akuker/RASCSI-micromod/hw/micromod_adapter/MicroMod_ATP_CarrierBoard.kicad_pcb

## KiCad design hw/micromod_adapter/MicroMod_ATP_CarrierBoard.kicad_pcb (2022-02-06)

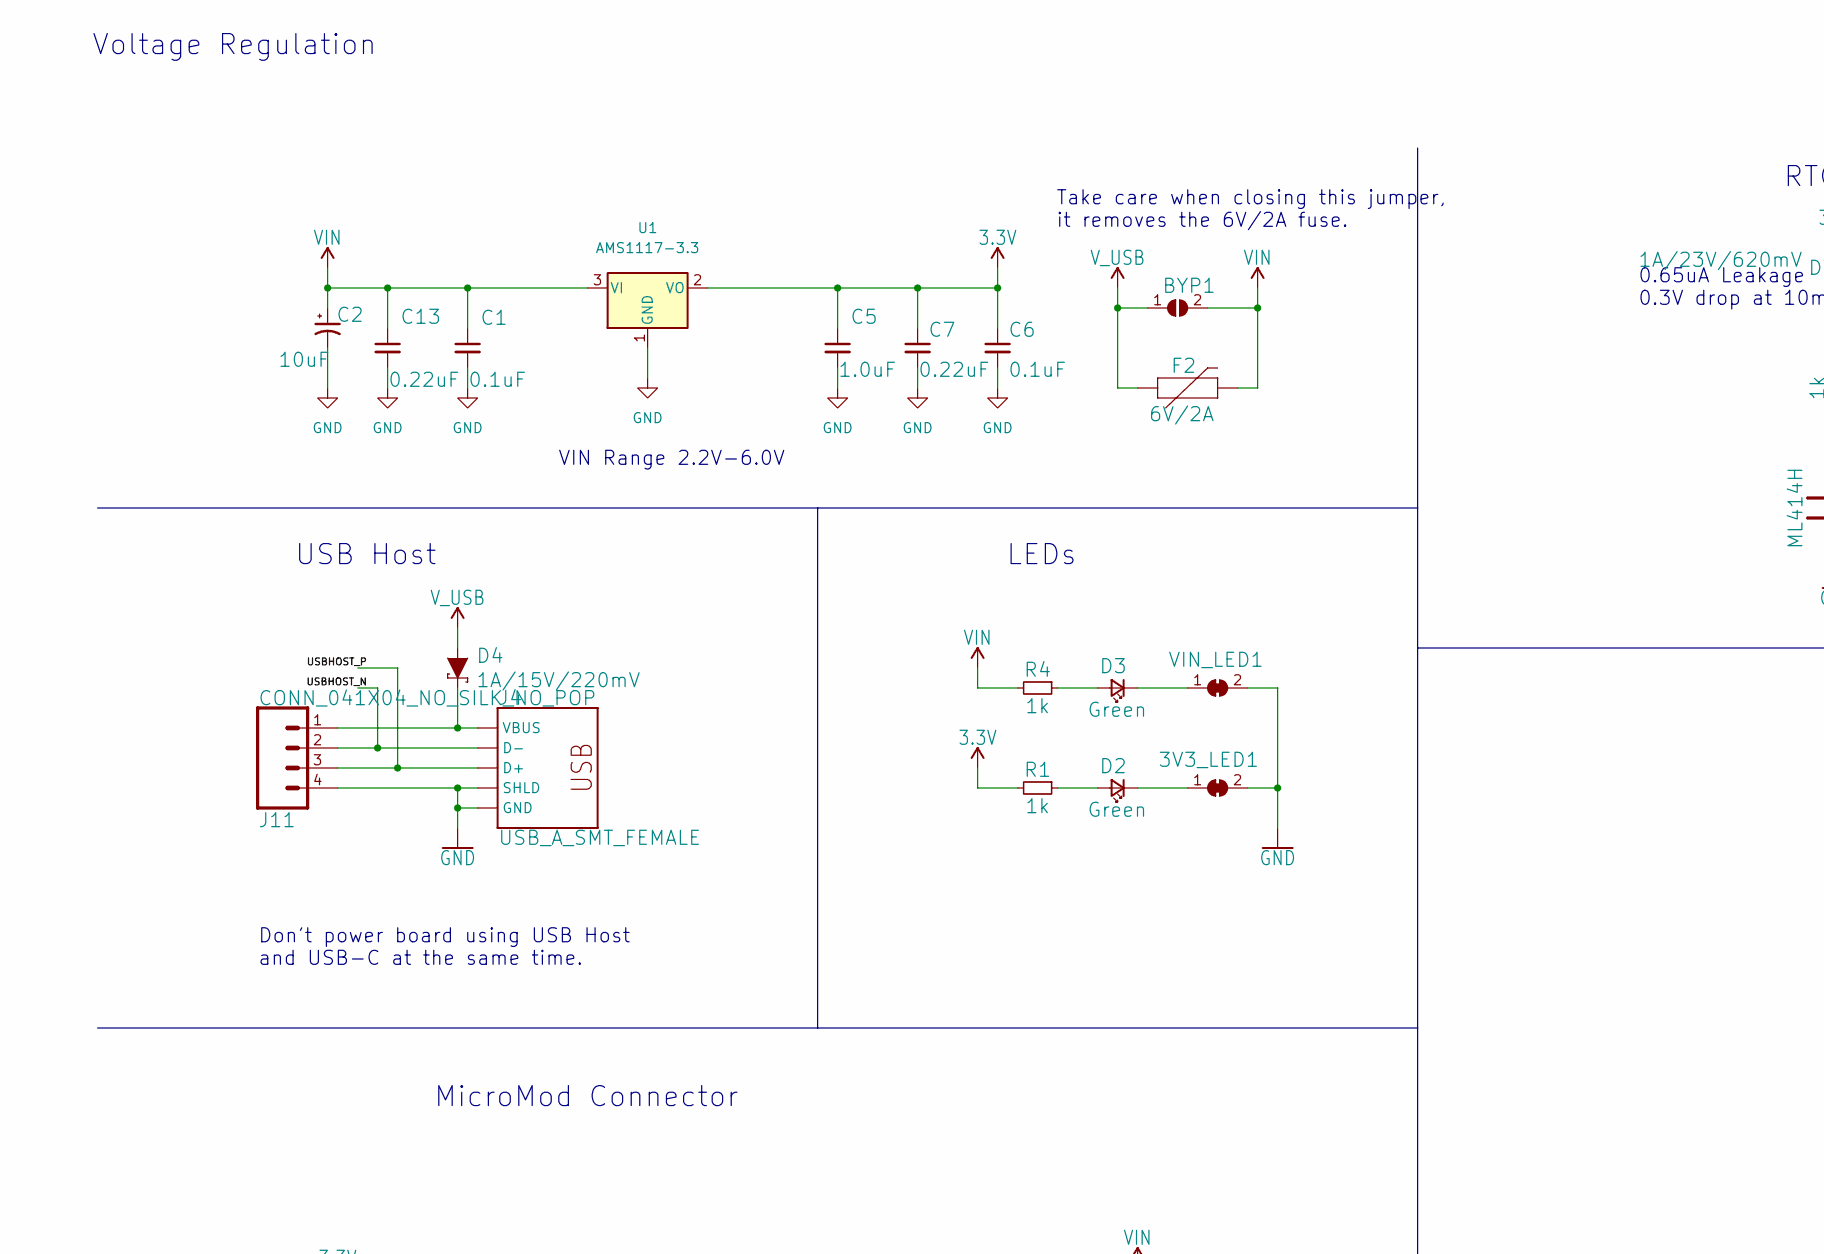
[picture p1: schematic MicroMod_ATP_CarrierBoard.kicad_sch, part in row 1, column 1]

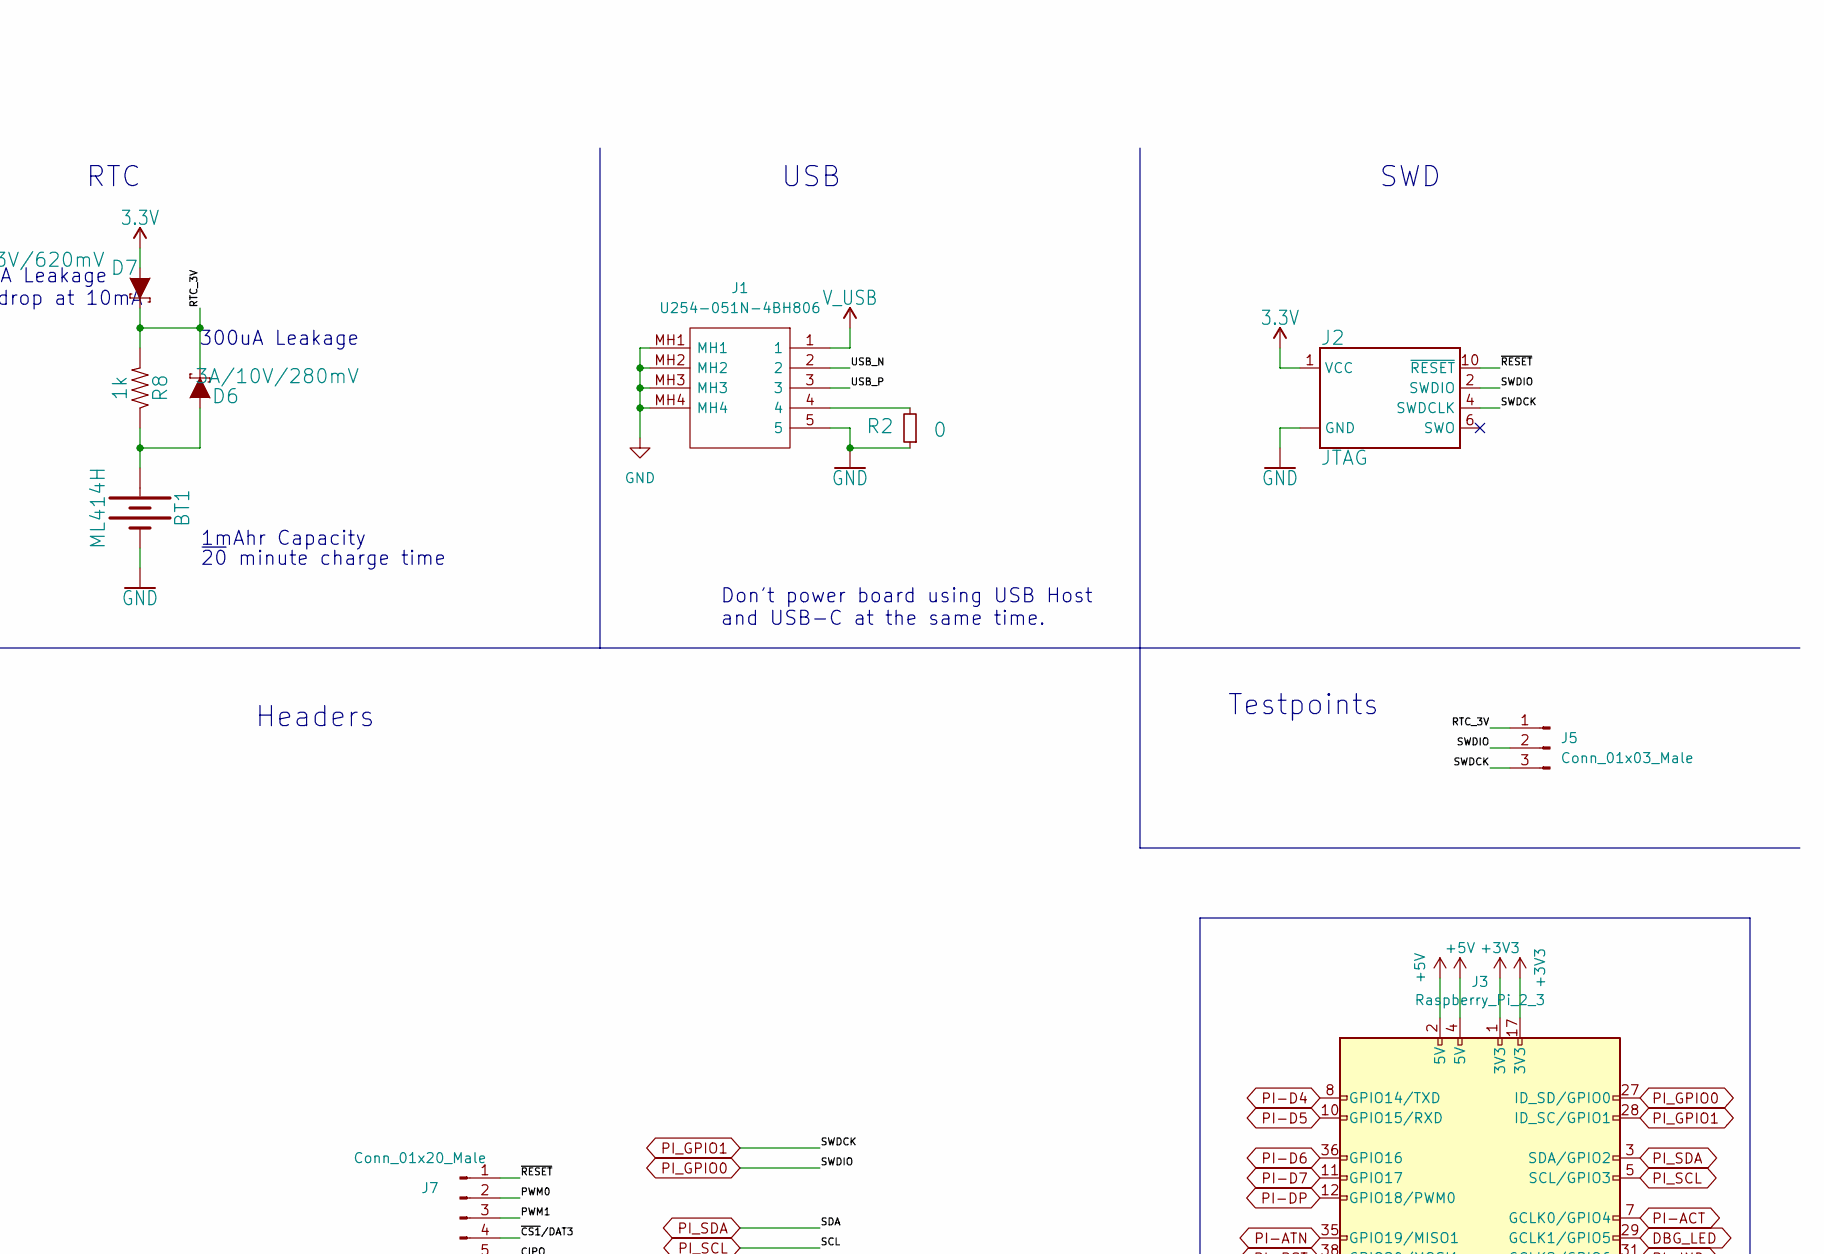
[picture p2: schematic MicroMod_ATP_CarrierBoard.kicad_sch, part in row 1, column 2]

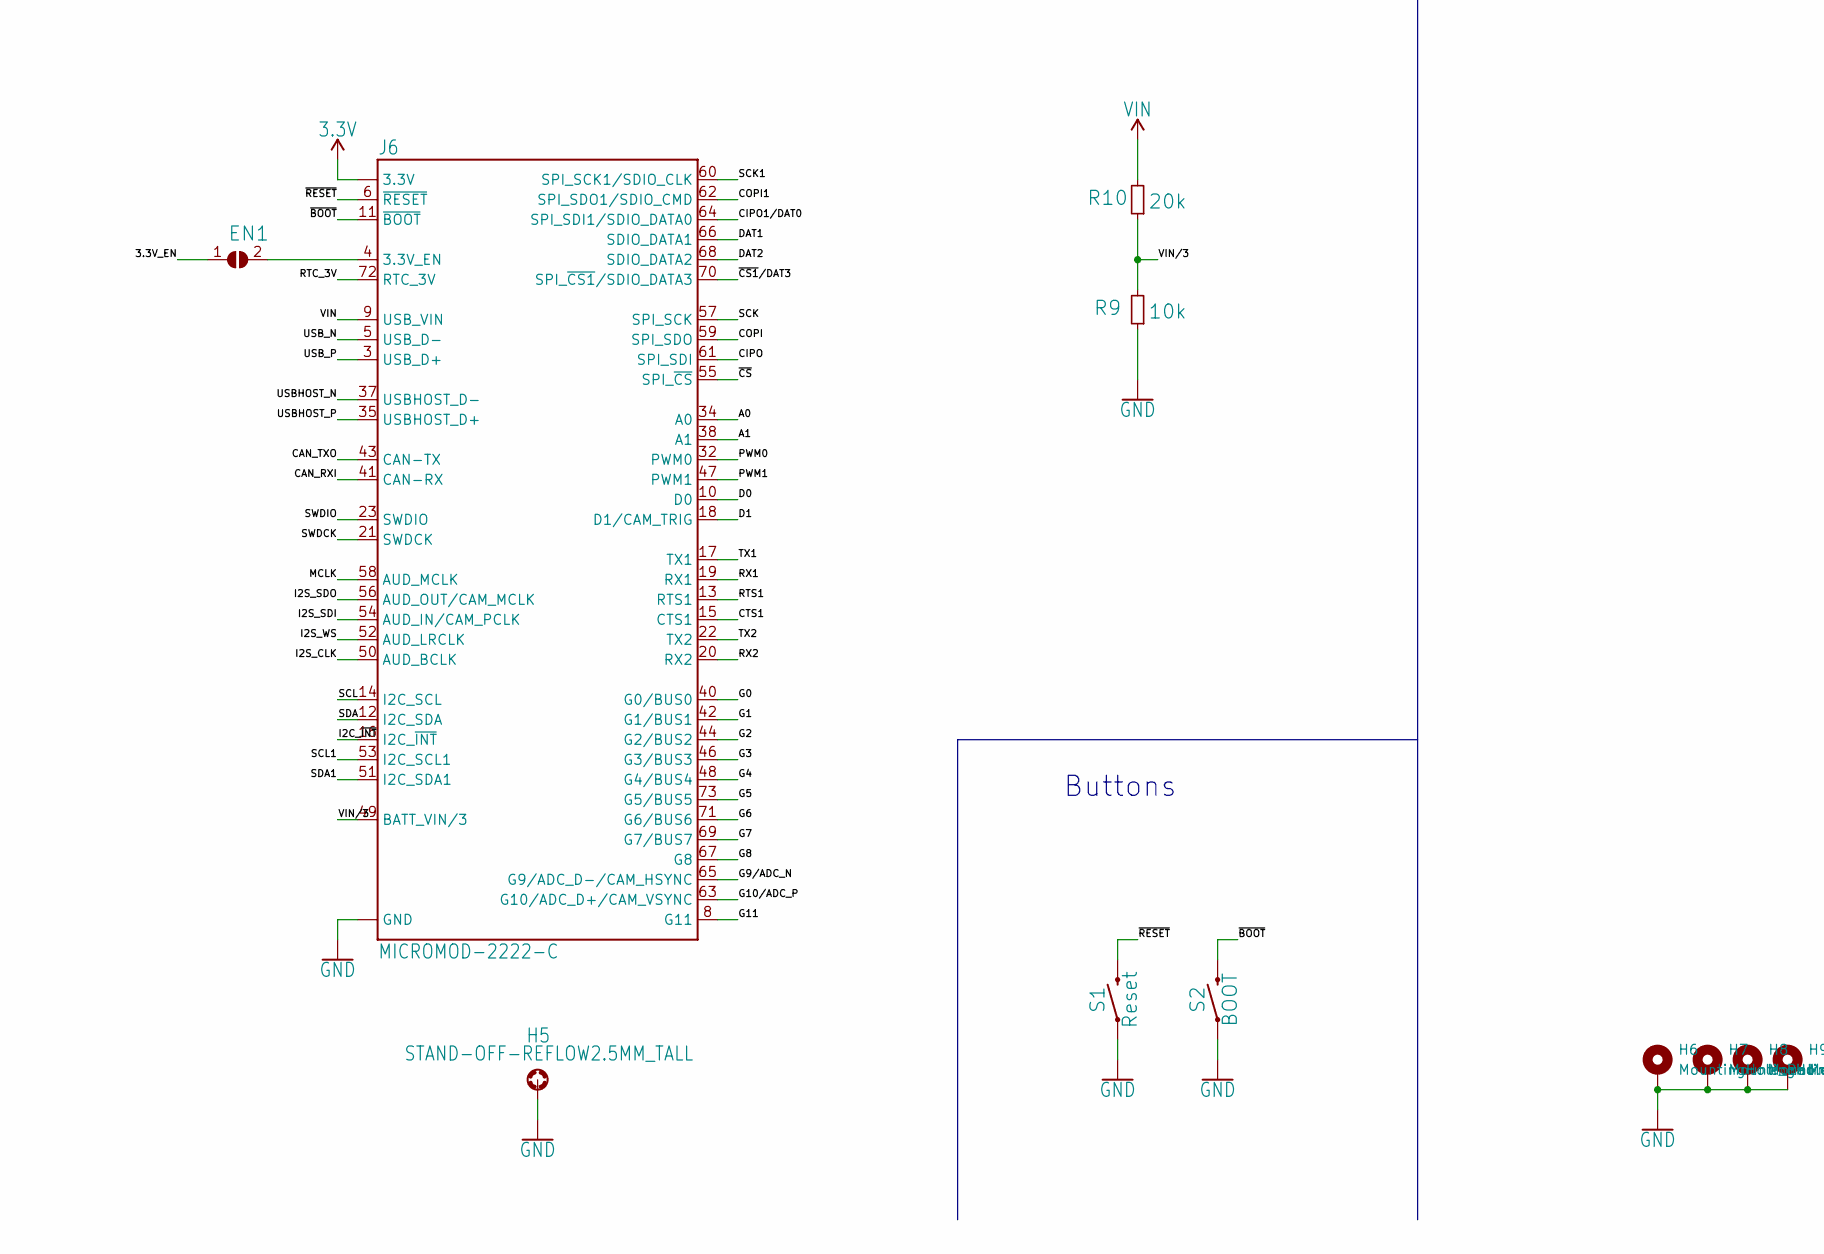
[picture p3: schematic MicroMod_ATP_CarrierBoard.kicad_sch, part in row 2, column 1]

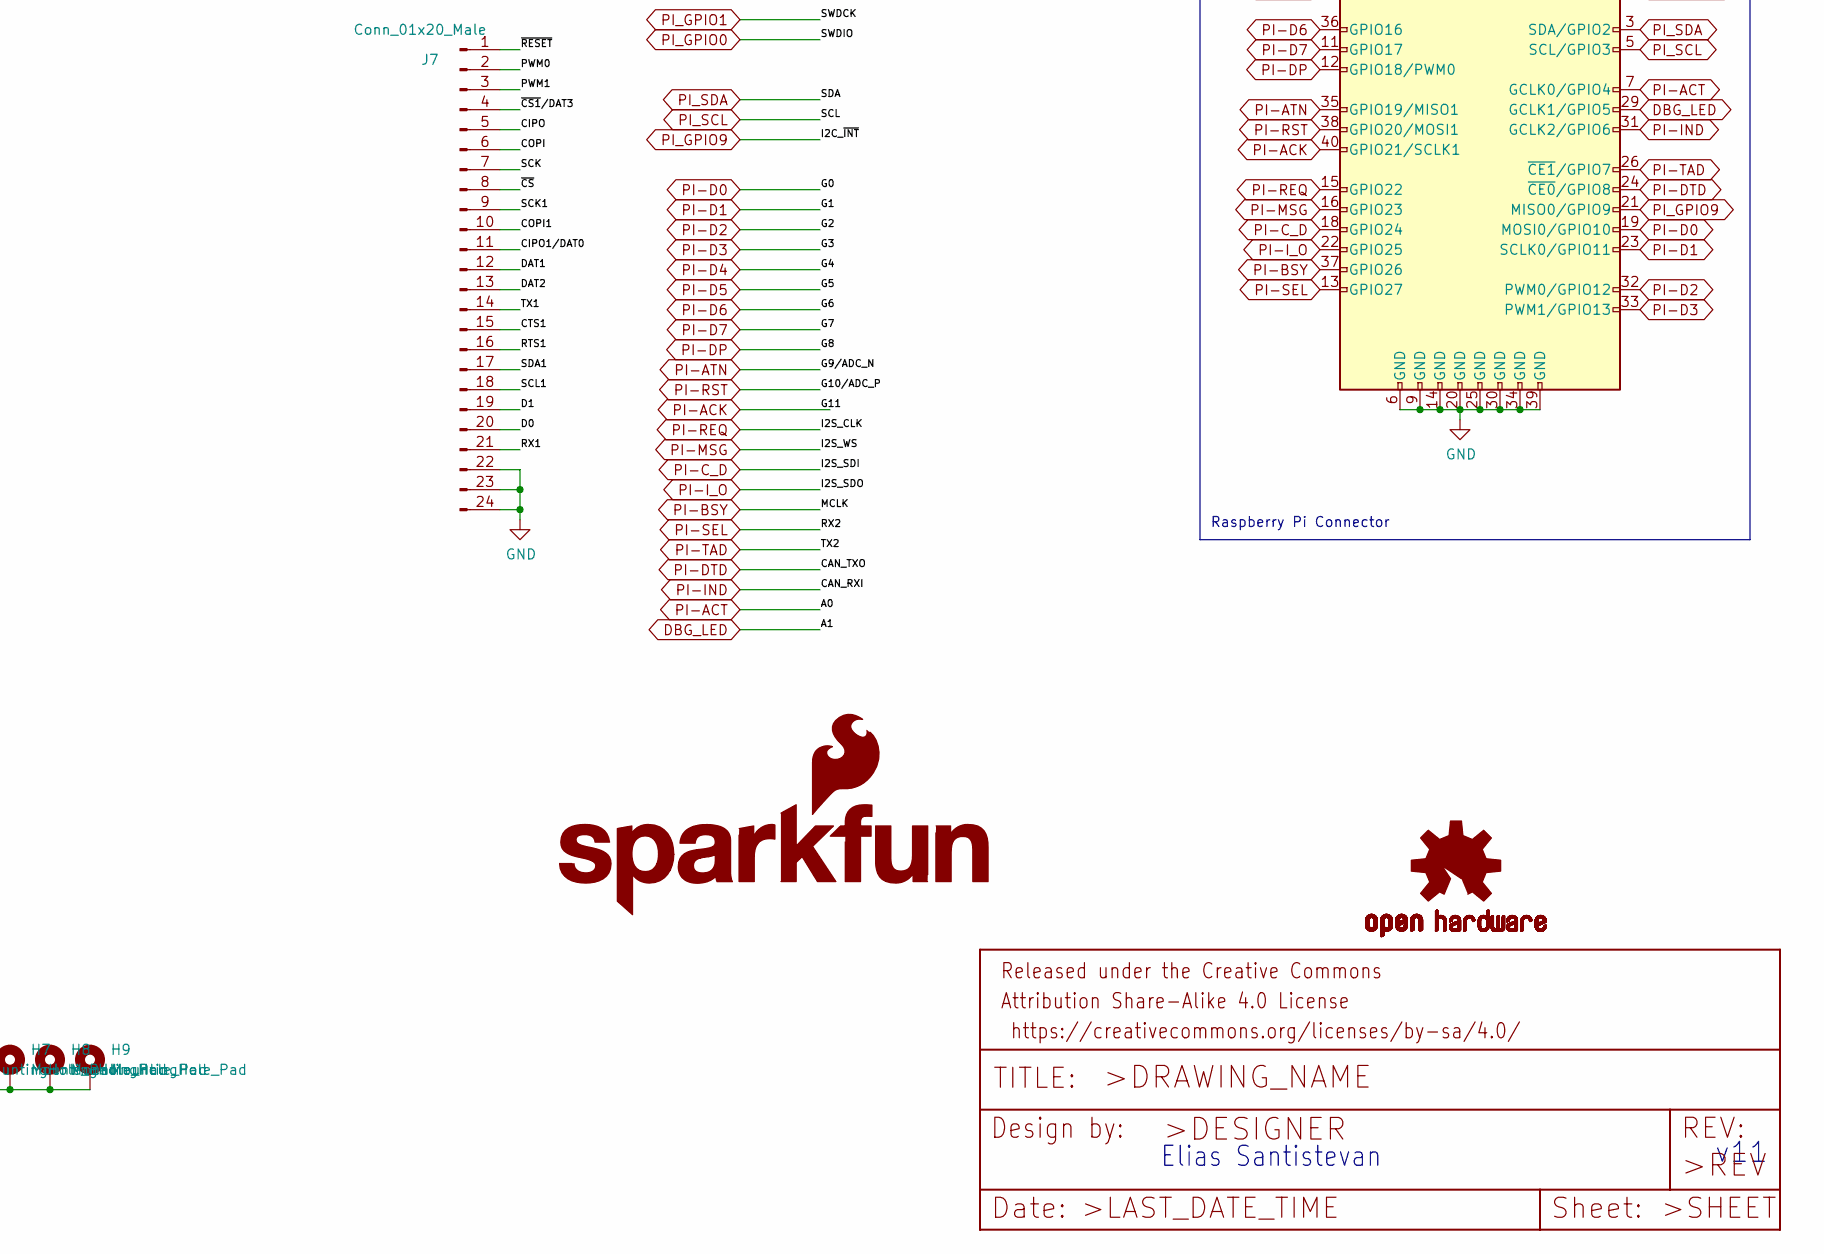
[picture p4: schematic MicroMod_ATP_CarrierBoard.kicad_sch, part in row 2, column 2]

Parts:
3V3_LED1: JUMPER-SMT_2_NC_TRACE_SILK; SolderJumper-2_P1.3mm_Bridged_RoundedPad1.0x1.5mm
BT1: ML414H; ML414H_IV01E
BYP1: JUMPER-SMT_2_NO_SILK; SolderJumper-2_P1.3mm_Open_RoundedPad1.0x1.5mm
C1, C6: 0.1uF; C_0805_2012Metric_Pad1.18x1.45mm_HandSolder; LCSC C49678
C2: 10uF; C_1206_3216Metric_Pad1.33x1.80mm_HandSolder; LCSC C7171
C5: 1.0uF; C_0603_1608Metric_Pad1.08x0.95mm_HandSolder; LCSC C15849
C7, C13: 0.22uF; C_0805_2012Metric_Pad1.18x1.45mm_HandSolder; LCSC C5378
D2, D3: Green; LED_0805_2012Metric_Pad1.15x1.40mm_HandSolder; LCSC C2297
D4: 1A/15V/220mV; DO-214BA
D6: 3A/10V/280mV; SOD-323
D7: 1A/23V/620mV; SOD-323
EN1: JUMPER-SMT_2_NO_SILK; SolderJumper-2_P1.3mm_Open_RoundedPad1.0x1.5mm
F2: 6V/2A; 1210
FRAME1: FRAME-LEDGER; CREATIVE_COMMONS
H5: STAND-OFF-REFLOW2.5MM_TALL; STAND-OFF-REFLOW-M2.5
H6, H7, H8, H9: MountingHole_Pad; MountingHole_2.7mm_M2.5_Pad_Via
J1: U254-051N-4BH806; U254051N4BH806; Manufacturer_Part_Number U254-051N-4BH806
J2: JTAG; 2X5-PTH-1.27MM
J3: Raspberry_Pi_2_3; PinSocket_2x20_P2.54mm_Vertical; Manufacturer_Part_Number C50982; LCSC C50982
J4: USB_A_SMT_FEMALE; USB-A-S-SILK-FEMALE
J5: Conn_01x03_Male; PinHeader_1x03_P2.54mm_Vertical
J6: MICROMOD-2222-C; M.2-CONNECTOR-E
J7: Conn_01x20_Male; PinHeader_1x24_P1.00mm_Vertical
J11: CONN_041X04_NO_SILK_NO_POP; 1X04_NO_SILK
LOGO1: SFE_LOGO_NAME_FLAME.1_INCH; SFE_LOGO_NAME_FLAME_.1
LOGO3: OSHW-LOGOMINI; OSHW-LOGO-MINI
R1, R4: 1k; C_0805_2012Metric_Pad1.18x1.45mm_HandSolder; LCSC C17737
R2: 0; R_0805_2012Metric_Pad1.20x1.40mm_HandSolder; lcsc C17477
R8: 1k; 0603
R9: 10k; R_0805_2012Metric_Pad1.20x1.40mm_HandSolder; LCSC C17414
R10: 20k; R_0805_2012Metric_Pad1.20x1.40mm_HandSolder
S1: Reset; SW_PUSH_6mm
S2: BOOT; SW_PUSH_6mm
U1: AMS1117-3.3; SOT-223-3_TabPin2; LCSC C6186
VIN_LED1: JUMPER-SMT_2_NC_TRACE_SILK; SolderJumper-2_P1.3mm_Bridged_RoundedPad1.0x1.5mm

Connections:
3.3V: C5.1, C6.1, C7.1, D7.A, J2.1 (VCC), J6.2 (3.3V), J6.74 (3.3V), R1.2, U1.2 (VO)
+3V3: J3.1 (3V3), J3.17 (3V3)
+5V: J3.2 (5V), J3.4 (5V)
/3.3V_EN: EN1.1 (A)
/CIPO: J6.61 (SPI_SDI), J7.5
/CIPO1/DAT0: J6.64 (SPI_SDI1/SDIO_DATA0), J7.11
/COPI: J6.59 (SPI_SDO), J7.6
/COPI1: J6.62 (SPI_SDO1/SDIO_CMD), J7.10
/CTS1: J6.15 (CTS1), J7.15
/D0: J6.10 (D0), J7.20
/D1: J6.18 (D1/CAM_TRIG), J7.19
/DAT1: J6.66 (SDIO_DATA1), J7.12
/DAT2: J6.68 (SDIO_DATA2), J7.13
/PWM0: J6.32 (PWM0), J7.2
/PWM1: J6.47 (PWM1), J7.3
/RTC_3V: D6.C, D7.C, J5.1, J6.72 (RTC_3V), R8.2
/RTS1: J6.13 (RTS1), J7.16
/RX1: J6.19 (RX1), J7.21
/SCK: J6.57 (SPI_SCK), J7.7
/SCK1: J6.60 (SPI_SCK1/SDIO_CLK), J7.9
/SCL1: J6.53 (I2C_SCL1), J7.18
/SDA1: J6.51 (I2C_SDA1), J7.17
/TX1: J6.17 (TX1), J7.14
/USBHOST_N: J4.D-, J6.37 (USBHOST_D-), J11.2
/USBHOST_P: J4.D+, J6.35 (USBHOST_D+), J11.3
/USB_N: J1.2, J6.5 (USB_D-)
/USB_P: J1.3, J6.3 (USB_D+)
/VIN/3: J6.49 (BATT_VIN/3), R9.2, R10.1
/~BOOT: J6.11 (~BOOT), S2.3 (2), S2.4 (2)
/~CS1/DAT3: J6.70 (SPI_~CS1/SDIO_DATA3), J7.4
/~CS: J6.55 (SPI_~CS), J7.8
/~RESET: J2.10 (~RESET), J6.6 (~RESET), J7.1, S1.3 (2), S1.4 (2)
DBG_LED: J3.29 (GCLK1/GPIO5), J6.38 (A1)
GND: 3V3_LED1.2 (B), BT1.-, C1.2, C2.2, C5.2, C6.2, C7.2, C13.2, H5.1, H6.1, H7.1, H8.1, H9.1, J1.5, J1.MH1, J1.MH2, J1.MH3, J1.MH4, J2.3 (GND), J2.5 (GND), J2.9 (GND), J3.6 (GND), J3.9 (GND), J3.14 (GND), J3.20 (GND), J3.25 (GND), J3.30 (GND), J3.34 (GND), J3.39 (GND), J4.GND, J4.SHLD1 (SHLD), J4.SHLD2 (SHLD), J6.1 (GND), J6.7 (GND), J6.33 (GND), J6.36 (GND), J6.39 (GND), J6.45 (GND), J6.75 (GND), J7.22, J7.23, J7.24, J11.4, R2.1, R9.1, S1.1, S1.2 (1), S2.1, S2.2 (1), U1.1 (GND), VIN_LED1.2 (B)
unnamed: 3V3_LED1.1 (A), D2.1 (K)
unnamed: BT1.+, D6.A, R8.1
unnamed: D3.2 (A), R4.1
unnamed: D4.C, J4.VBUS, J11.1
unnamed: J1.4, R2.2
unnamed: EN1.2 (B), J6.4 (3.3V_EN)
unnamed: D2.2 (A), R1.1
unnamed: D3.1 (K), VIN_LED1.1 (A)
PI-ACK: J3.40 (GPIO21/SCLK1), J6.8 (G11)
PI-ACT: J3.7 (GCLK0/GPIO4), J6.34 (A0)
PI-ATN: J3.35 (GPIO19/MISO1), J6.65 (G9/ADC_D-/CAM_HSYNC)
PI-BSY: J3.37 (GPIO26), J6.58 (AUD_MCLK)
PI-C_D: J3.18 (GPIO24), J6.54 (AUD_IN/CAM_PCLK)
PI-D0: J3.19 (MOSI0/GPIO10), J6.40 (G0/BUS0)
PI-D1: J3.23 (SCLK0/GPIO11), J6.42 (G1/BUS1)
PI-D2: J3.32 (PWM0/GPIO12), J6.44 (G2/BUS2)
PI-D3: J3.33 (PWM1/GPIO13), J6.46 (G3/BUS3)
PI-D4: J3.8 (GPIO14/TXD), J6.48 (G4/BUS4)
PI-D5: J3.10 (GPIO15/RXD), J6.73 (G5/BUS5)
PI-D6: J3.36 (GPIO16), J6.71 (G6/BUS6)
PI-D7: J3.11 (GPIO17), J6.69 (G7/BUS7)
PI-DP: J3.12 (GPIO18/PWM0), J6.67 (G8)
PI-DTD: J3.24 (~CE0/GPIO8), J6.43 (CAN-TX)
PI-IND: J3.31 (GCLK2/GPIO6), J6.41 (CAN-RX)
PI-I_O: J3.22 (GPIO25), J6.56 (AUD_OUT/CAM_MCLK)
PI-MSG: J3.16 (GPIO23), J6.52 (AUD_LRCLK)
PI-REQ: J3.15 (GPIO22), J6.50 (AUD_BCLK)
PI-RST: J3.38 (GPIO20/MOSI1), J6.63 (G10/ADC_D+/CAM_VSYNC)
PI-SEL: J3.13 (GPIO27), J6.20 (RX2)
PI-TAD: J3.26 (~CE1/GPIO7), J6.22 (TX2)
PI_GPIO0: J2.2 (SWDIO), J3.27 (ID_SD/GPIO0), J5.2, J6.23 (SWDIO)
PI_GPIO1: J2.4 (SWDCLK), J3.28 (ID_SC/GPIO1), J5.3, J6.21 (SWDCK)
PI_GPIO9: J3.21 (MISO0/GPIO9), J6.16 (I2C_~INT)
PI_SCL: J3.5 (SCL/GPIO3), J6.14 (I2C_SCL)
PI_SDA: J3.3 (SDA/GPIO2), J6.12 (I2C_SDA)
VIN: BYP1.2 (B), C1.1, C2.1, C13.1, F2.2, J6.9 (USB_VIN), R4.2, R10.2, U1.3 (VI)
V_USB: BYP1.1 (A), D4.A, F2.1, J1.1

Notes on the sheet:
Voltage Regulation
Don't power board using USB Host and USB-C at the same time.
1mAhr Capacity
USB Host
Elias Santistevan
Raspberry Pi Connector
300uA Leakage
~{20} minute charge time
0.65uA Leakage 0.3V drop at 10mA
USB
SWD
Take care when closing this jumper, it removes the 6V/2A fuse.
MicroMod Connector
v11
LEDs
Headers
RTC
Testpoints
Buttons
VIN Range 2.2V-6.0V

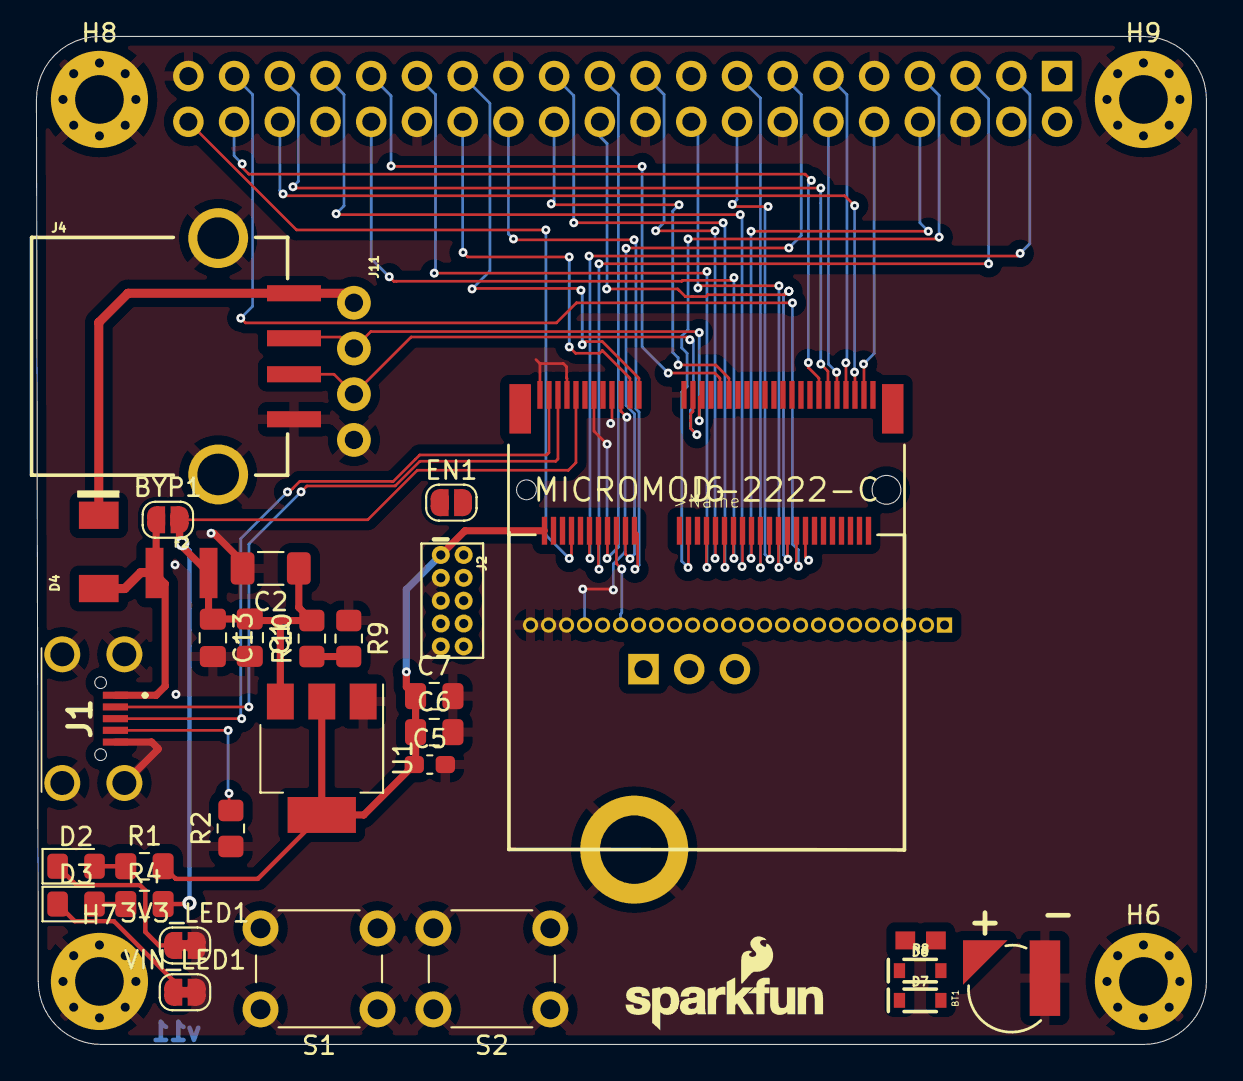
[picture p5: board MicroMod_ATP_CarrierBoard.kicad_pcb from above]

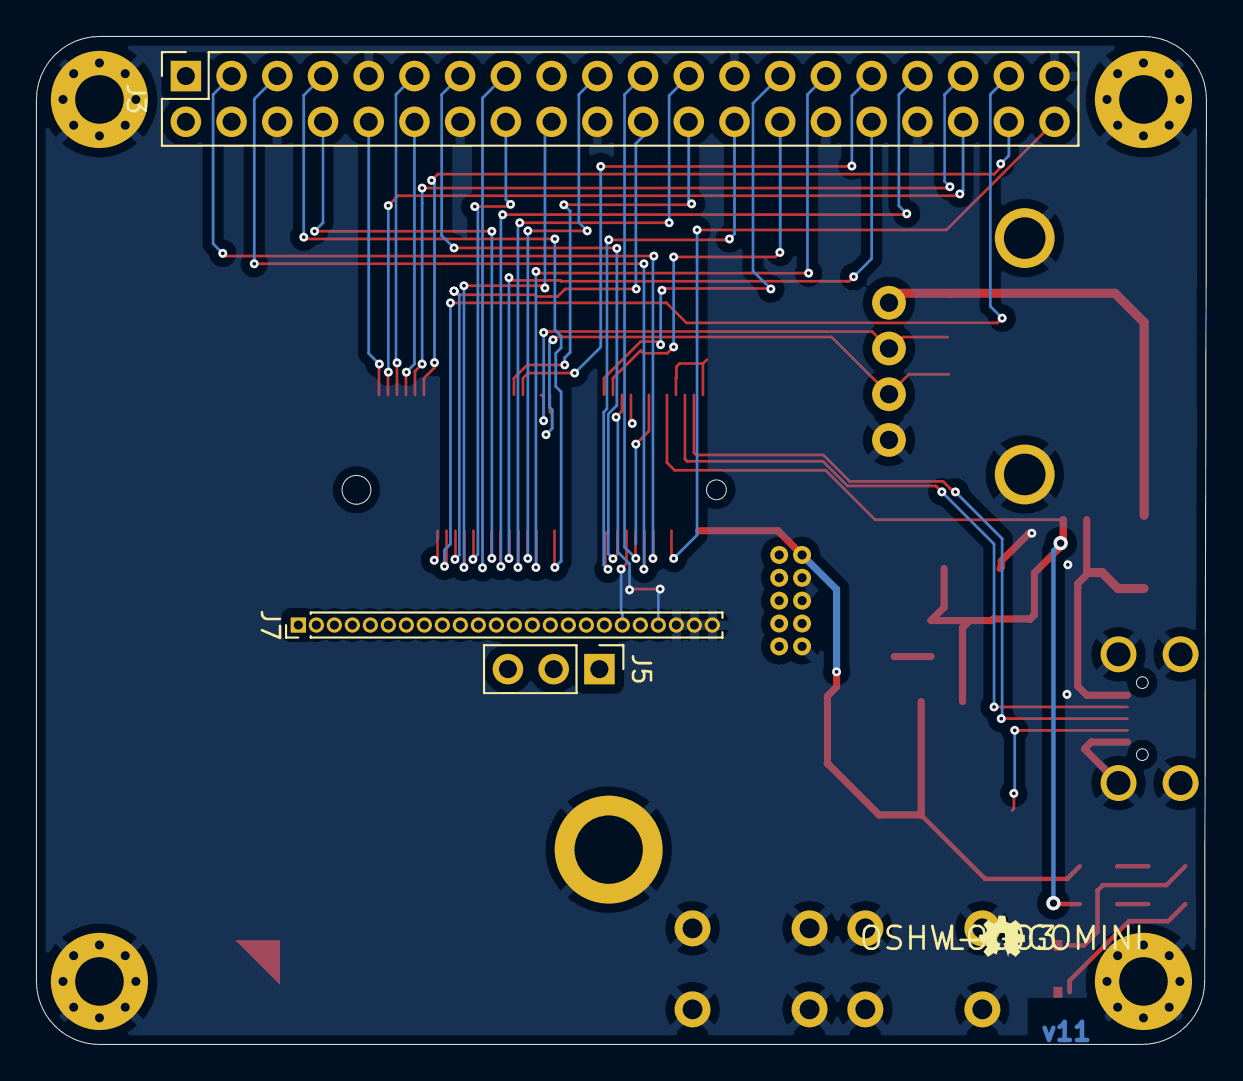
[picture p6: board MicroMod_ATP_CarrierBoard.kicad_pcb from below]

Board: 2 copper layers, 65.0 x 56.0 mm, 42 parts (4 on the bottom side), 69 nets.
