akuker/RASCSI-micromod/(commit log)

2022-02-02 Convert Sparkfun carrierboard to kicad
    [MicroMod_ATP_CarrierBoard.kicad_pcb, MicroMod_ATP_CarrierBoard.kicad_sch]
2022-02-02 did some stuff
    [MicroMod_ATP_CarrierBoard.kicad_pcb, MicroMod_ATP_CarrierBoard.kicad_sch]
2022-02-06 more routing
    [MicroMod_ATP_CarrierBoard.kicad_pcb]
