akuker/RASCSI-micromod/(notices)

Notices in the files:
hw/micromod_adapter/MicroMod_ATP_CarrierBoard.kicad_sch:
https://creativecommons.org/licenses/by-sa/4.0
Released under the Creative Commons
parts and their libraries:
Released under the Creative Commons Attribution Share-Alike 4.0 License
